joamats/feup-IntegratedLaboratory/README.md

## Biomedical Integrated Laboratory: Control by Ocular Movement

* João Carlos Ramos Gonçalves de Matos

* Maria Jorge Miranda Loureiro

* Maria Manuel Domingos Carvalho

Grade: 19/20
