joamats/feup-IntegratedLaboratory/Apresentação/Apresentação_OcularControl.pdf

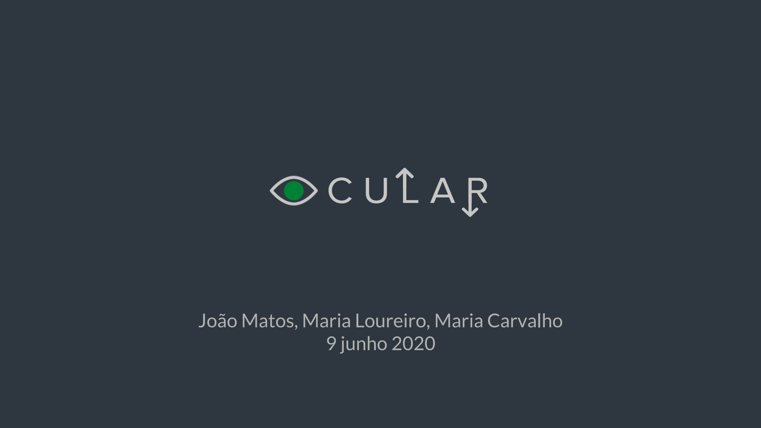
[picture p27: page 1]

# João Matos, Maria Loureiro, Maria Carvalho 9 junho 2020

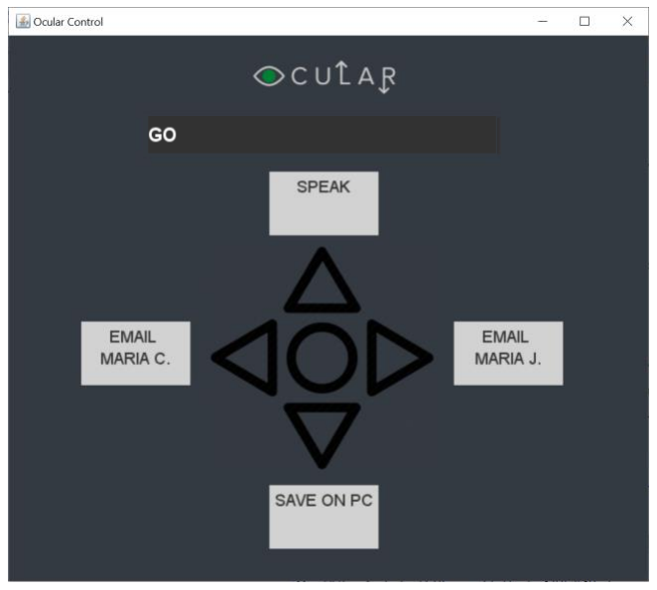
[picture p28: figure]

# is a simulated communication

platform controlled by ocular movement.

## The user can write text using simulated eye

movements in four directions.

## After writing the message, it can be sent it via email, saved in textfile, or read out loud!

# What is Ocular?

# Ocular Consists of 3 Components

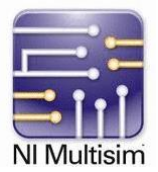
[picture p29: figure]

## Analog EOG Signal Processing

## Eye Movement Simulation

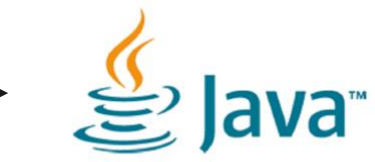
[picture p30: figure]

## Message Writing & Exporting Options

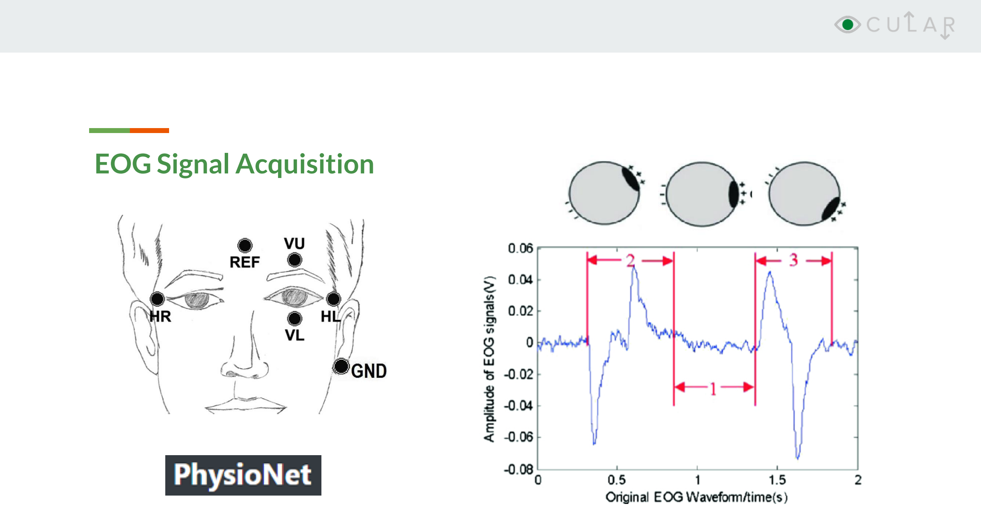
[picture p31: page 4]

# EOG Signal Acquisition

# Multisim Circuit

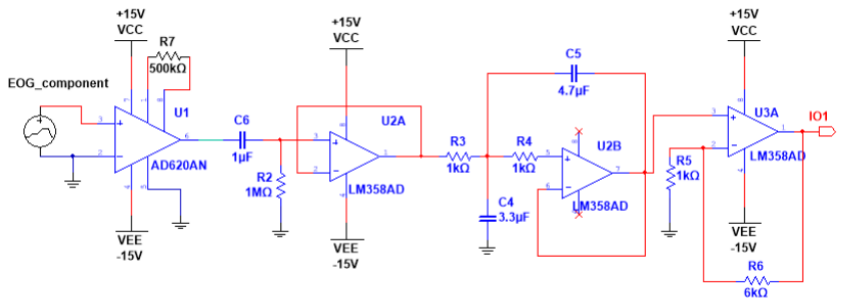
[picture p32: figure]

# Programme Demonstration

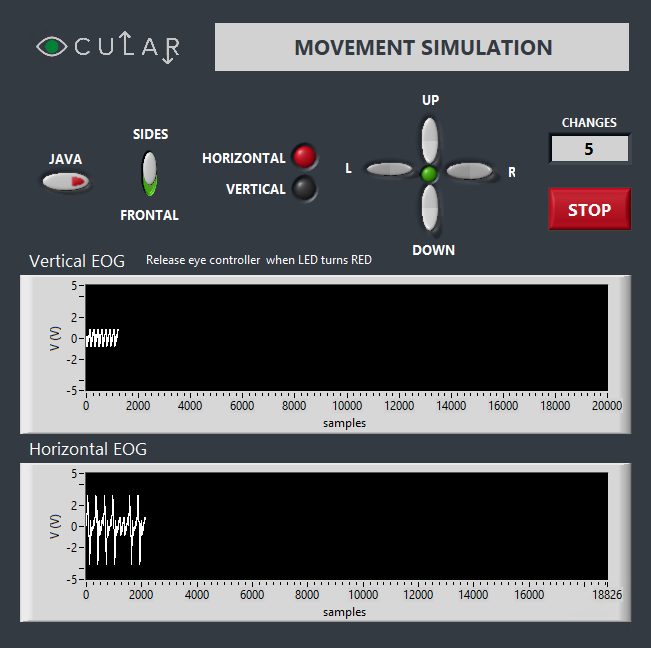
[picture p33: figure]
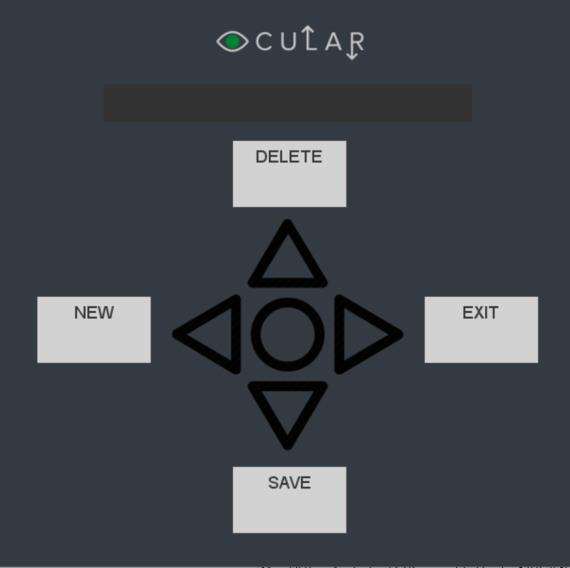
[picture p34: figure]

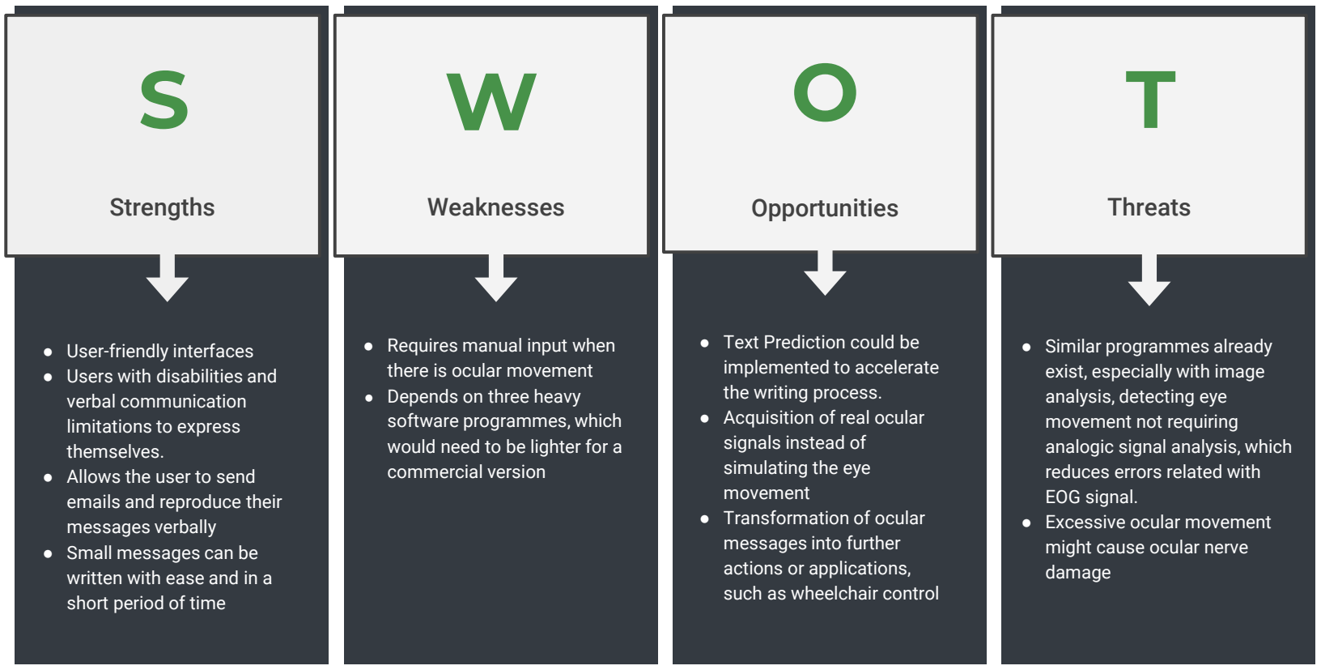
[picture p35: figure]
SWOT analysis; Strengths; ● User-friendly interfaces ● Users with disabilities and verbal communication limitations to express themselves. ● Allows the user to send emails and reproduce their messages verbally ● Small messages can be written with ease and in a short period of time; Weaknesses; ● Requires manual input when there is ocular movement ● Depends on three heavy software programmes, which would need to be lighter for a commercial version; ● Text Prediction could be implemented to accelerate the writing process. ● Acquisition of real ocular signals instead of simulating the eye movement ● Transformation of ocular messages into further actions or applications, such as wheelchair control; Threats; ● Similar programmes already exist, especially with image analysis, detecting eye movement not requiring analogic signal analysis, which reduces errors related with EOG signal. ● Excessive ocular movement might cause ocular nerve damage; Opportunities

!&A
