joamats/feup-IntegratedLaboratory/Pencil/OcularControl_Pencil.pdf

# Background

Exported from Pencil - Thu Apr 30 2020 12:49:20 GMT+0100 (Hora de verão da Europa Ocidental) - Page 1 of 15

# Title

# Homepage

Exported from Pencil - Thu Apr 30 2020 12:49:20 GMT+0100 (Hora de verão da Europa Ocidental) - Page 2 of 15

# FINISH

# EXIT

# DELETE

# NEW

# FIRST

Exported from Pencil - Thu Apr 30 2020 12:49:20 GMT+0100 (Hora de verão da Europa Ocidental) - Page 3 of 15

A, B, C, D,E, F, G, H, I, J,

## K, L, M, N, O, EXIT

0, 1, 2, 3, 4, 5, 6, 7, 8, 9,

## +, -, /, *, =, EXIT

P, Q, R, S, T, U, V, X, Y,

## Z, À, Á, É, Í, Ó, EXIT

., ,, ;, ?, !, ', ", (, ), %, @, _,

## :, &, [SPACE], EXIT

# SECOND

Exported from Pencil - Thu Apr 30 2020 12:49:20 GMT+0100 (Hora de verão da Europa Ocidental) - Page 4 of 15

## A, B, C, D

## E, F, G, H

## I, J, K, L

## M, N, O, EXIT

# THIRD

Exported from Pencil - Thu Apr 30 2020 12:49:20 GMT+0100 (Hora de verão da Europa Ocidental) - Page 5 of 15

## EXIT

O

M

N

# FOURTH

Exported from Pencil - Thu Apr 30 2020 12:49:20 GMT+0100 (Hora de verão da Europa Ocidental) - Page 6 of 15

A, B, C, D,E, F, G, H, I, J,

## K, L, M, N, O, EXIT

0, 1, 2, 3, 4, 5, 6, 7, 8, 9,

## +, -, /, *, =, EXIT

P, Q, R, S, T, U, V, X, Y,

## Z, À, Á, É, Í, Ó, EXIT

., ,, ;, ?, !, ', ", (, ), %, @, _,

## :, &, [SPACE], EXIT

O

# FIFTH

Exported from Pencil - Thu Apr 30 2020 12:49:20 GMT+0100 (Hora de verão da Europa Ocidental) - Page 7 of 15

## A, B, C, D

## E, F, G, H

## I, J, K, L

## M, N, O, EXIT

O

# SIXTH

Exported from Pencil - Thu Apr 30 2020 12:49:20 GMT+0100 (Hora de verão da Europa Ocidental) - Page 8 of 15

I

J

K

L

O

# SEVEN

Exported from Pencil - Thu Apr 30 2020 12:49:20 GMT+0100 (Hora de verão da Europa Ocidental) - Page 9 of 15

A, B, C, D,E, F, G, H, I, J,

## K, L, M, N, O, EXIT

0, 1, 2, 3, 4, 5, 6, 7, 8, 9,

## +, -, /, *, =, EXIT

P, Q, R, S, T, U, V, X, Y,

## Z, À, Á, É, Í, Ó, EXIT

., ,, ;, ?, !, ', ", (, ), %, @, _,

## :, &, [SPACE], EXIT

OL

P, Q, R, S, T, U, V, X, Y,

## Z, À, Á, É, Í, Ó, EXIT

# EIGHT

Exported from Pencil - Thu Apr 30 2020 12:49:20 GMT+0100 (Hora de verão da Europa Ocidental) - Page 10 of 15

## P, Q, R, S

OL

P, Q, R, S | T, U, V, X

## Y, Z, Á, À

# NINE

Exported from Pencil - Thu Apr 30 2020 12:49:20 GMT+0100 (Hora de verão da Europa Ocidental) - Page 11 of 15

Y

À | Z

Á

OL

# TEN

Exported from Pencil - Thu Apr 30 2020 12:49:20 GMT+0100 (Hora de verão da Europa Ocidental) - Page 12 of 15

A, B, C, D,E, F, G, H, I, J,

## K, L, M, N, O, EXIT

0, 1, 2, 3, 4, 5, 6, 7, 8, 9,

## +, -, /, *, =, EXIT

P, Q, R, S, T, U, V, X, Y,

## Z, À, Á, É, Í, Ó, EXIT

., ,, ;, ?, !, ', ", (, ), %, @, _,

## :, &, [SPACE], EXIT

# OLÁ

A, B, C, D,E, F, G, H, I, J,

## K, L, M, N, O, EXIT

# ELEVEN

Exported from Pencil - Thu Apr 30 2020 12:49:20 GMT+0100 (Hora de verão da Europa Ocidental) - Page 13 of 15

## A, B, C, D

## E, F, G, H

## I, J, K, L

## M, N, O, EXIT

# OLÁ

## M, N, O, EXIT

# TWELVE

Exported from Pencil - Thu Apr 30 2020 12:49:20 GMT+0100 (Hora de verão da Europa Ocidental) - Page 14 of 15

## EXIT

O

M

N

# OLÁ

## EXIT

# THIRTEEN

Exported from Pencil - Thu Apr 30 2020 12:49:20 GMT+0100 (Hora de verão da Europa Ocidental) - Page 15 of 15

# FINISH

# EXIT

# DELETE

# NEW

# OLÁ
