joamats/feup-IntegratedLaboratory/Java+LabVIEW+Multisim/src/arrow250.png

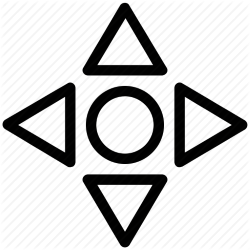
Java+LabVIEW+Multisim/src/arrow250.png
