joamats/feup-IntegratedLaboratory/(list of files, drawings)

Other design files:
Java+LabVIEW+Multisim/src/EOG_Negative.ms14
Java+LabVIEW+Multisim/src/EOG_Positive.ms14
Java+LabVIEW+Multisim/src/EOG_Repouso.ms14
